mvhaell/PortalZero/3d model/portal zero main.stl

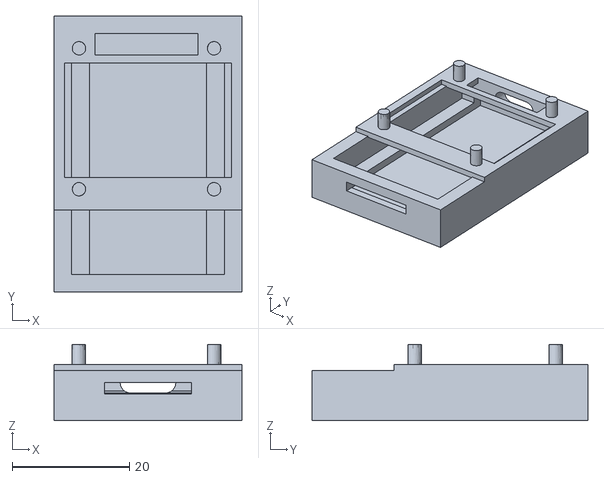
[picture p2: CAD file, 2026-11-10]
3d model/portal zero main.stl
32.0 x 47.0 x 12.9
