mvhaell/PortalZero/3d model/OLEDHolder.stl

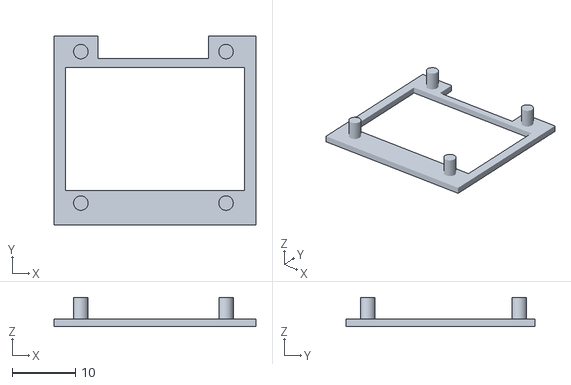
[picture p3: CAD file, 2026-11-10]
3d model/OLEDHolder.stl
32.0 x 30.0 x 4.65
