mvhaell/PortalZero/3d model/0007.stl

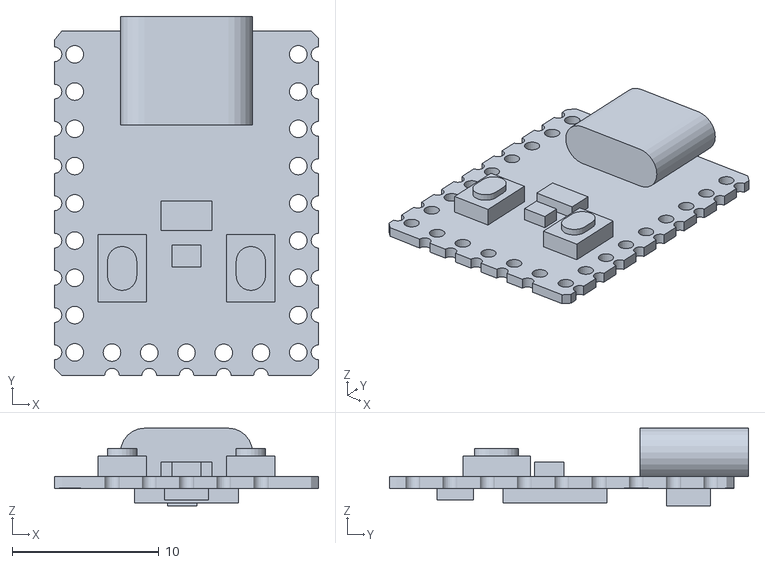
[picture p4: CAD file, 2026-11-10]
3d model/0007.stl
18.0 x 24.5 x 5.30
