mvhaell/PortalZero/3d model/portal zero lid.stl

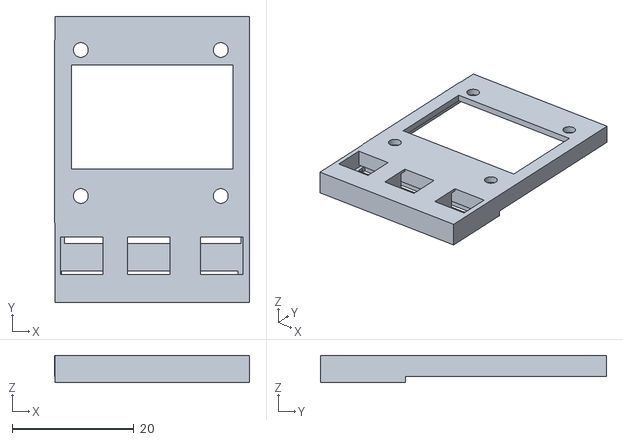
[picture p5: CAD file, 2026-11-10]
3d model/portal zero lid.stl
32.1 x 47.0 x 4.50
