mvhaell/PortalZero/3d model/Tactile_Push_Button.stl

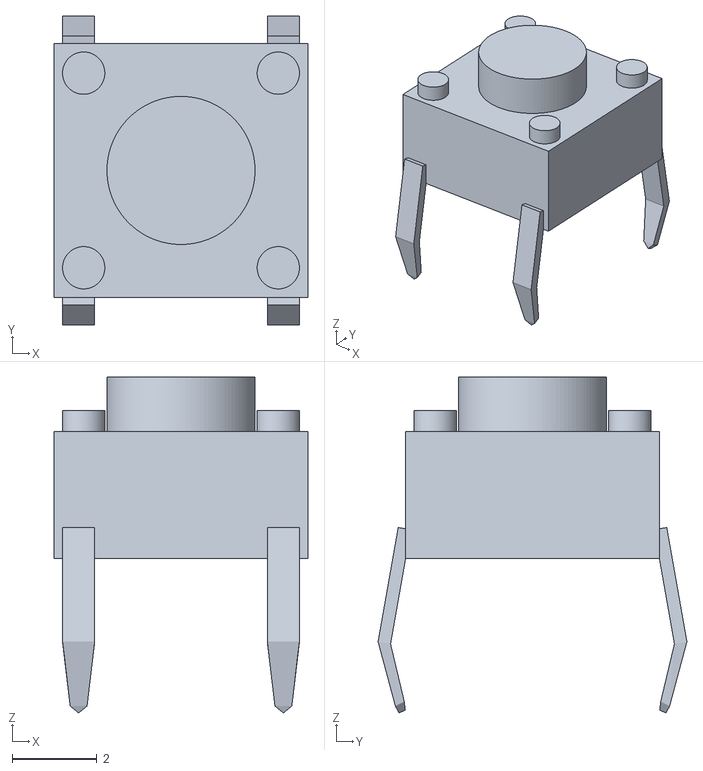
[picture p6: CAD file, 2026-11-10]
3d model/Tactile_Push_Button.stl
6.00 x 7.30 x 7.94
