mvhaell/PortalZero/3d model/OLEDHolderFront.stl

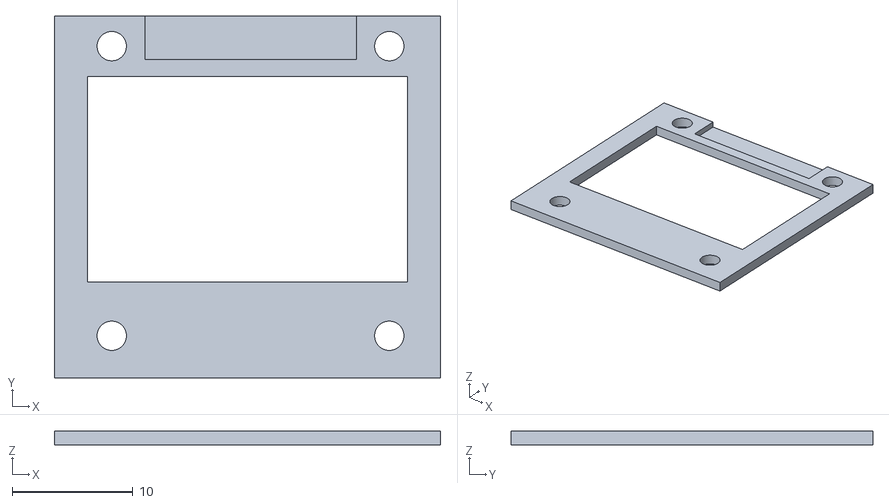
[picture p7: CAD file, 2026-11-10]
3d model/OLEDHolderFront.stl
32.0 x 30.0 x 1.20
