mvhaell/PortalZero/3d model/sd card breakout.stl

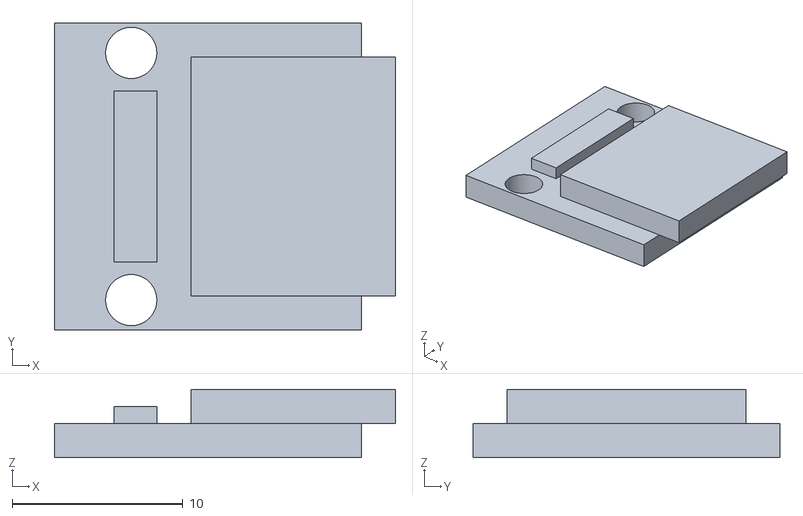
[picture p8: CAD file, 2026-11-10]
3d model/sd card breakout.stl
20.0 x 18.0 x 4.00
