mvhaell/PortalZero/PortalZero/oled.c

// Minimal driver for a 0.96" SSD1306 OLED (128x64) over I2C
#include <string.h>
#include "oled.h"

#ifndef OLED_HOST_TEST
#include "pico/stdlib.h"
#include "hardware/i2c.h"
#endif

static unsigned char fb[OLED_WIDTH * OLED_HEIGHT / 8];

// Classic 5x7 font, ASCII 0x20 to 0x7E (+ 0x7F = heart for favorites), column-wise, bit 0 = top
static const unsigned char font5x7[96][5] = {
    {0x00,0x00,0x00,0x00,0x00}, // ' '
    {0x00,0x00,0x5F,0x00,0x00}, // !
    {0x00,0x07,0x00,0x07,0x00}, // "
    {0x14,0x7F,0x14,0x7F,0x14}, // #
    {0x24,0x2A,0x7F,0x2A,0x12}, // $
    {0x23,0x13,0x08,0x64,0x62}, // %
    {0x36,0x49,0x55,0x22,0x50}, // &
    {0x00,0x05,0x03,0x00,0x00}, // '
    {0x00,0x1C,0x22,0x41,0x00}, // (
    {0x00,0x41,0x22,0x1C,0x00}, // )
    {0x14,0x08,0x3E,0x08,0x14}, // *
    {0x08,0x08,0x3E,0x08,0x08}, // +
    {0x00,0x50,0x30,0x00,0x00}, // ,
    {0x08,0x08,0x08,0x08,0x08}, // -
    {0x00,0x60,0x60,0x00,0x00}, // .
    {0x20,0x10,0x08,0x04,0x02}, // /
    {0x3E,0x51,0x49,0x45,0x3E}, // 0
    {0x00,0x42,0x7F,0x40,0x00}, // 1
    {0x42,0x61,0x51,0x49,0x46}, // 2
    {0x21,0x41,0x45,0x4B,0x31}, // 3
    {0x18,0x14,0x12,0x7F,0x10}, // 4
    {0x27,0x45,0x45,0x45,0x39}, // 5
    {0x3C,0x4A,0x49,0x49,0x30}, // 6
    {0x01,0x71,0x09,0x05,0x03}, // 7
    {0x36,0x49,0x49,0x49,0x36}, // 8
    {0x06,0x49,0x49,0x29,0x1E}, // 9
    {0x00,0x36,0x36,0x00,0x00}, // :
    {0x00,0x56,0x36,0x00,0x00}, // ;
    {0x08,0x14,0x22,0x41,0x00}, // <
    {0x14,0x14,0x14,0x14,0x14}, // =
    {0x00,0x41,0x22,0x14,0x08}, // >
    {0x02,0x01,0x51,0x09,0x06}, // ?
    {0x32,0x49,0x79,0x41,0x3E}, // @
    {0x7E,0x11,0x11,0x11,0x7E}, // A
    {0x7F,0x49,0x49,0x49,0x36}, // B
    {0x3E,0x41,0x41,0x41,0x22}, // C
    {0x7F,0x41,0x41,0x22,0x1C}, // D
    {0x7F,0x49,0x49,0x49,0x41}, // E
    {0x7F,0x09,0x09,0x09,0x01}, // F
    {0x3E,0x41,0x49,0x49,0x7A}, // G
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
    {0x02,0x04,0x08,0x10,0x20}, // backslash
    {0x00,0x41,0x41,0x7F,0x00}, // ]
    {0x04,0x02,0x01,0x02,0x04}, // ^
    {0x40,0x40,0x40,0x40,0x40}, // _
    {0x00,0x01,0x02,0x04,0x00}, // `
    {0x20,0x54,0x54,0x54,0x78}, // a
    {0x7F,0x48,0x44,0x44,0x38}, // b
    {0x38,0x44,0x44,0x44,0x20}, // c
    {0x38,0x44,0x44,0x48,0x7F}, // d
    {0x38,0x54,0x54,0x54,0x18}, // e
    {0x08,0x7E,0x09,0x01,0x02}, // f
    {0x0C,0x52,0x52,0x52,0x3E}, // g
    {0x7F,0x08,0x04,0x04,0x78}, // h
    {0x00,0x44,0x7D,0x40,0x00}, // i
    {0x20,0x40,0x44,0x3D,0x00}, // j
    {0x7F,0x10,0x28,0x44,0x00}, // k
    {0x00,0x41,0x7F,0x40,0x00}, // l
    {0x7C,0x04,0x18,0x04,0x78}, // m
    {0x7C,0x08,0x04,0x04,0x78}, // n
    {0x38,0x44,0x44,0x44,0x38}, // o
    {0x7C,0x14,0x14,0x14,0x08}, // p
    {0x08,0x14,0x14,0x18,0x7C}, // q
    {0x7C,0x08,0x04,0x04,0x08}, // r
    {0x48,0x54,0x54,0x54,0x20}, // s
    {0x04,0x3F,0x44,0x40,0x20}, // t
    {0x3C,0x40,0x40,0x20,0x7C}, // u
    {0x1C,0x20,0x40,0x20,0x1C}, // v
    {0x3C,0x40,0x30,0x40,0x3C}, // w
    {0x44,0x28,0x10,0x28,0x44}, // x
    {0x0C,0x50,0x50,0x50,0x3C}, // y
    {0x44,0x64,0x54,0x4C,0x44}, // z
    {0x00,0x08,0x36,0x41,0x00}, // {
    {0x00,0x00,0x7F,0x00,0x00}, // |
    {0x00,0x41,0x36,0x08,0x00}, // }
    {0x02,0x01,0x02,0x04,0x02}, // ~
    {0x0C,0x1E,0x3C,0x1E,0x0C}, // 0x7F: heart (favorite)
};

static void set_pixel(int x, int y, bool on) {
    if (x < 0 || x >= OLED_WIDTH || y < 0 || y >= OLED_HEIGHT) return;
    if (on) fb[x + (y / 8) * OLED_WIDTH] |=  (1 << (y & 7));
    else    fb[x + (y / 8) * OLED_WIDTH] &= ~(1 << (y & 7));
}

#ifndef OLED_HOST_TEST
static void oled_cmd(unsigned char c) {
    unsigned char buf[2] = {0x00, c};   // 0x00 = command follows
    i2c_write_blocking(OLED_I2C, OLED_ADDR, buf, 2, false);
}
#endif

void oled_init(void) {
#ifndef OLED_HOST_TEST
    i2c_init(OLED_I2C, 400 * 1000);
    gpio_set_function(OLED_SDA_PIN, GPIO_FUNC_I2C);
    gpio_set_function(OLED_SCL_PIN, GPIO_FUNC_I2C);
    gpio_pull_up(OLED_SDA_PIN);
    gpio_pull_up(OLED_SCL_PIN);
    sleep_ms(50);   // give the display a moment to power up

    static const unsigned char init_seq[] = {
        0xAE,       // display off
        0xD5, 0x80, // clock divider
        0xA8, 0x3F, // multiplex 64 rows
        0xD3, 0x00, // no offset
        0x40,       // start line 0
        0x8D, 0x14, // internal charge pump on
        0x20, 0x00, // horizontal addressing
        0xA1,       // mirror columns (correct orientation)
        0xC8,       // mirror rows (correct orientation)
        0xDA, 0x12, // COM pins for 128x64
        0x81, 0xCF, // contrast
        0xD9, 0xF1, // Precharge
        0xDB, 0x40, // VCOMH
        0xA4,       // display follows RAM
        0xA6,       // normal (not inverted)
        0x2E,       // no scrolling
        0xAF        // display on
    };
    for (unsigned i = 0; i < sizeof(init_seq); i++) oled_cmd(init_seq[i]);
#endif
    oled_clear();
    oled_show();
}

void oled_clear(void) {
    memset(fb, 0, sizeof(fb));
}

void oled_show(void) {
#ifndef OLED_HOST_TEST
    oled_cmd(0x21); oled_cmd(0); oled_cmd(OLED_WIDTH - 1);       // columns
    oled_cmd(0x22); oled_cmd(0); oled_cmd(OLED_HEIGHT / 8 - 1);  // pages
    static unsigned char buf[sizeof(fb) + 1];
    buf[0] = 0x40;                                               // 0x40 = data follows
    memcpy(buf + 1, fb, sizeof(fb));
    i2c_write_blocking(OLED_I2C, OLED_ADDR, buf, sizeof(buf), false);
#endif
}

void oled_fill_rect(int x, int y, int w, int h, bool on) {
    for (int i = x; i < x + w; i++)
        for (int j = y; j < y + h; j++)
            set_pixel(i, j, on);
}

void oled_hline(int y) {
    oled_fill_rect(0, y, OLED_WIDTH, 1, true);
}

// One character is 6 pixels wide (5 + 1 spacing) and 8 high -> 21 characters per line
// invert = light character cells with dark text (for a selection bar,
// fill the whole line with oled_fill_rect first)
void oled_text(int x, int y, const char *s, bool invert) {
    for (; *s; s++, x += 6) {
        unsigned char c = (unsigned char)*s;
        if (c < 0x20 || c > 0x7F) c = '?';
        const unsigned char *g = font5x7[c - 0x20];
        for (int col = 0; col < 6; col++) {
            unsigned char bits = (col < 5) ? g[col] : 0x00;
            for (int row = 0; row < 8; row++) {
                bool on = (bits >> row) & 1;
                set_pixel(x + col, y + row, invert ? !on : on);
            }
        }
    }
}

void oled_text_center(int y, const char *s, bool invert) {
    // ignore leading/trailing spaces
    while (*s == ' ') s++;
    int len = (int)strlen(s);
    while (len > 0 && s[len - 1] == ' ') len--;
    char tmp[32];
    if (len > 21) len = 21;
    memcpy(tmp, s, len);
    tmp[len] = '\0';
    int x = (OLED_WIDTH - len * 6) / 2;
    if (invert) oled_fill_rect(0, y, OLED_WIDTH, 8, true);
    oled_text(x, y, tmp, invert);
}
